nkocode/test-equipment-iphone-duo-foldatron/gallery/assets/rev-c-preview.jpg

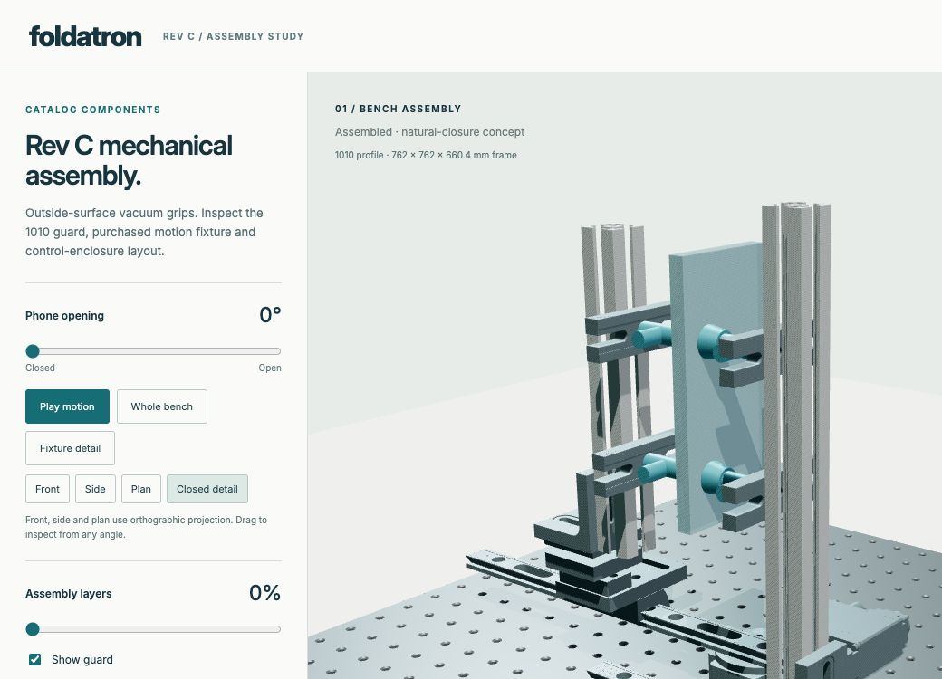
gallery/assets/rev-c-preview.jpg
