nkocode/test-equipment-iphone-duo-foldatron/revisions/rev-b/project/hardware/rev-b/cad/fasteners/README.md

# Standard-derived fastener envelopes

Nominal ISO4762 geometry from Bossard BN612 dimensional tables (S28). These are project-generated STEP files, not original Bossard CAD. Threads, under-head radii and finish are omitted. Use the fastener schedule for length, thread, strength and quantity; do not manufacture screws from these envelopes.
