nkocode/test-equipment-iphone-duo-foldatron/revisions/rev-b/project/hardware/rev-b/THIRD-PARTY-NOTICES.md

# Third-party notices

The E-005 board-placement drawing, `views/controller-board.png`,
and the Adafruit-derived grid in
`controller-board.json` are adaptations of the Perma-Proto Half board,
designed by Limor Fried/Ladyada for Adafruit Industries. They are licensed
under Creative Commons Attribution-ShareAlike 3.0 Unported, not the
repository MIT license. Changes: added foldatron component placement,
wiring assignments, dimensions and circuit connectivity verification.

Original source: https://github.com/adafruit/Adafruit-Perma-Proto-PCB
Product: https://www.adafruit.com/product/1609
License: https://creativecommons.org/licenses/by-sa/3.0/

The complete original attribution/readme and license are retained in
`third-party/adafruit/`. The original EAGLE file is retained unchanged in
the local vendor-reference archive and can be fetched from source S36.
Other sheets in the drawing-book collection retain their own licenses.
The project generation scripts remain under the repository MIT license.

Vendor datasheets and original CAD retain their respective copyrights.
They are not relicensed by the project. The source register distinguishes
original downloads, reconstructed geometry and unavailable source files.
