nkocode/test-equipment-iphone-duo-foldatron/gallery/assets/rev-a-preview.jpg

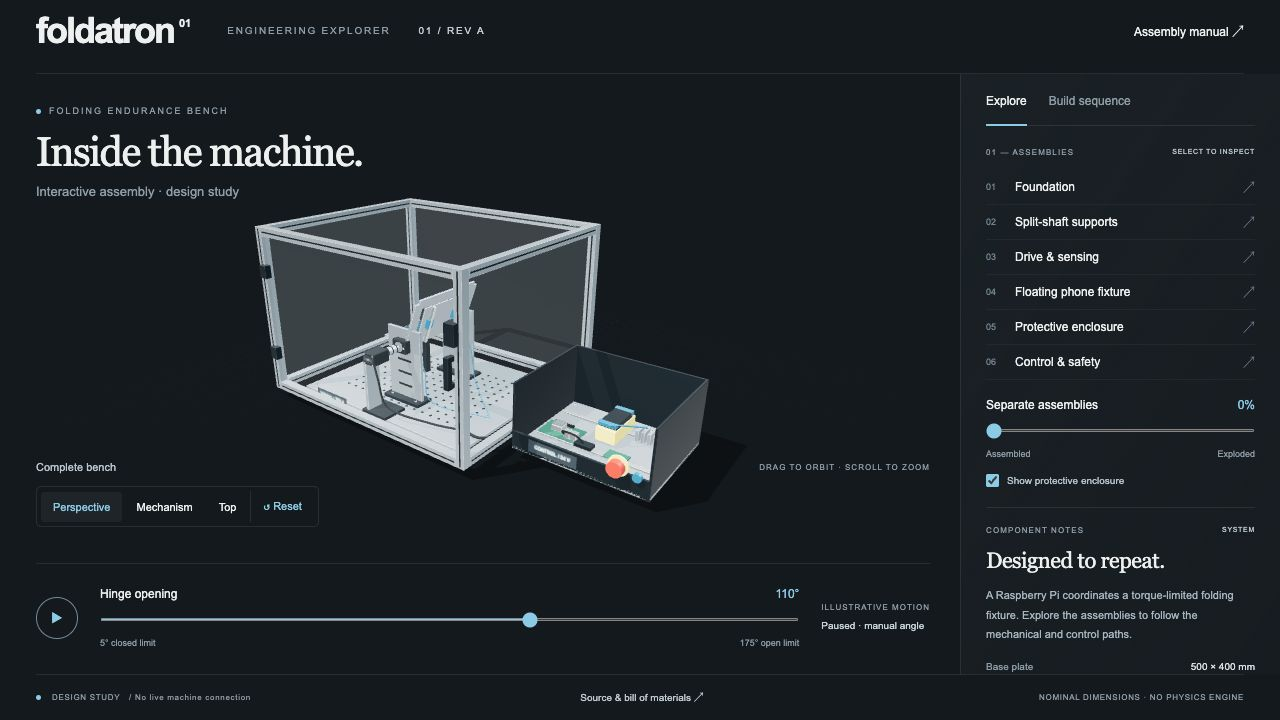
gallery/assets/rev-a-preview.jpg
