nkocode/test-equipment-iphone-duo-foldatron/revisions/rev-c/hardware/cad/top-interface-study.step

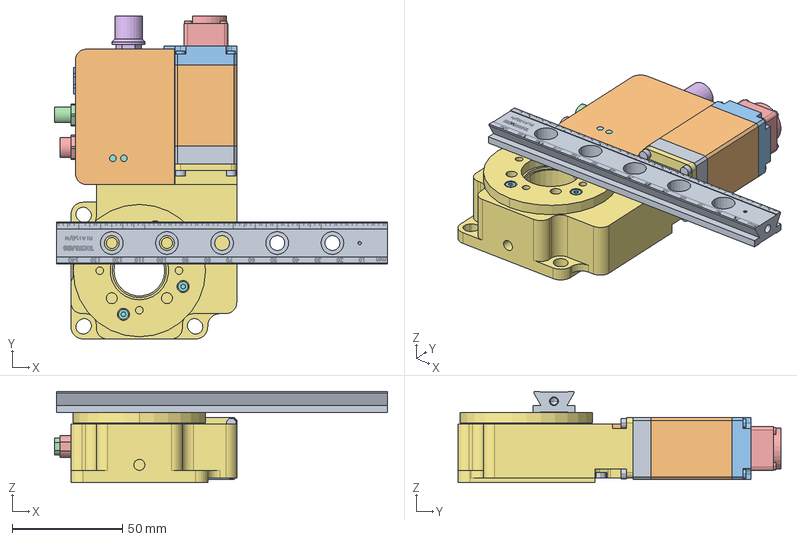
[picture p3: CAD file, 2026-11-13]
revisions/rev-c/hardware/cad/top-interface-study.step
151.0 x 146.4 x 41.3 mm
