nkocode/test-equipment-iphone-duo-foldatron/revisions/rev-c/hardware/cad/structure-study.step

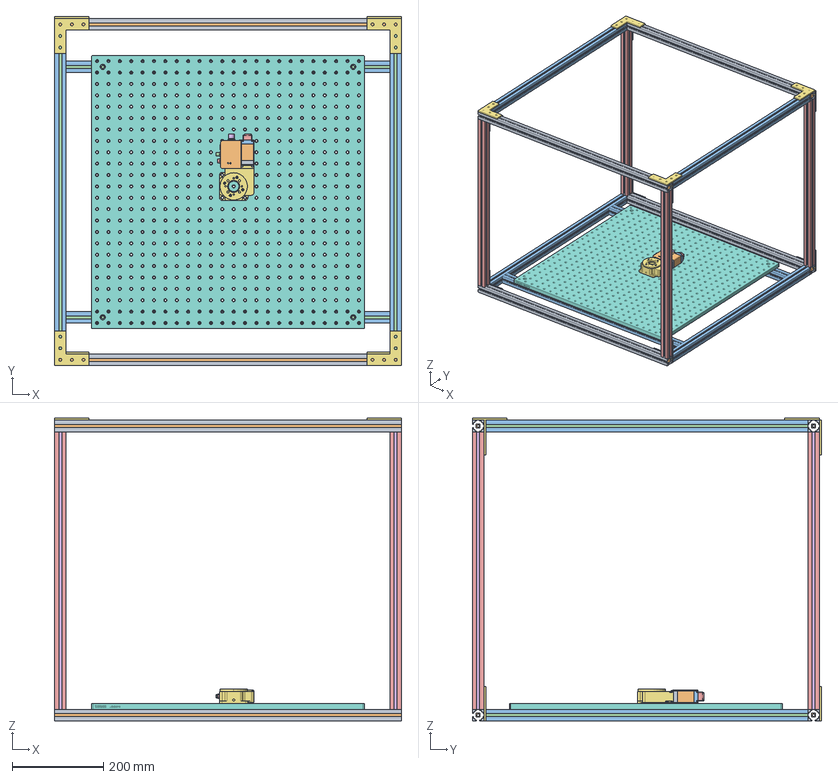
[picture p4: CAD file, 2026-11-13]
revisions/rev-c/hardware/cad/structure-study.step
762.0 x 766.8 x 665.2 mm
