nkocode/test-equipment-iphone-duo-foldatron/revisions/rev-b/project/hardware/rev-b/cad/B105.step

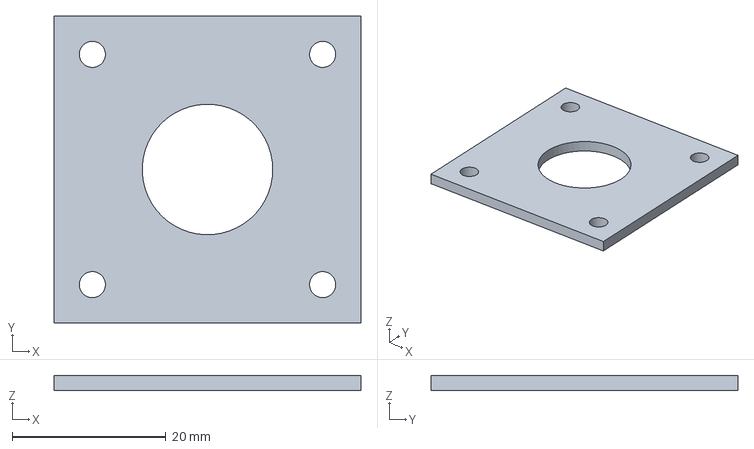
[picture p5: CAD file, 2026-11-06, an earlier design]
revisions/rev-b/project/hardware/rev-b/cad/B105.step
40.0 x 40.0 x 2.00 mm
