nkocode/test-equipment-iphone-duo-foldatron/revisions/rev-b/project/hardware/rev-b/cad/B102.step

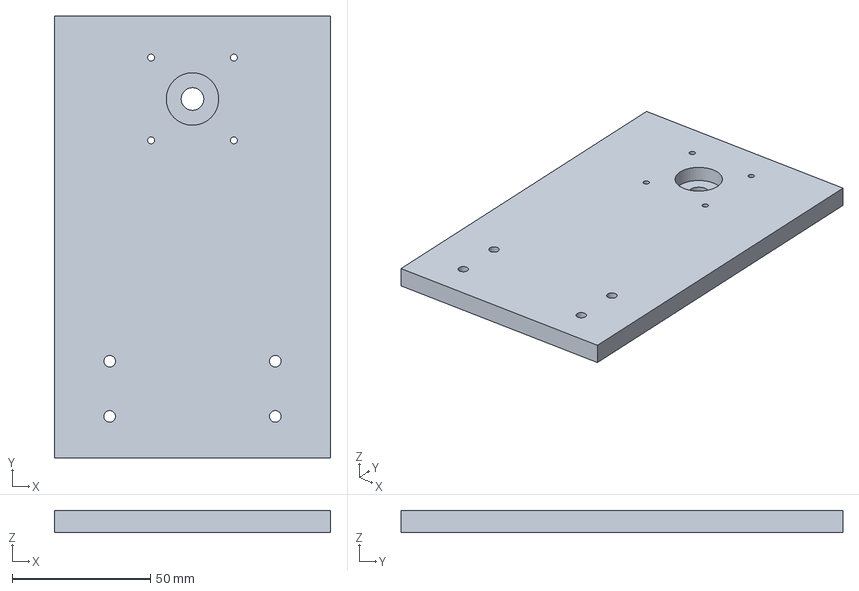
[picture p6: CAD file, 2026-11-06, an earlier design]
revisions/rev-b/project/hardware/rev-b/cad/B102.step
100.0 x 160.0 x 8.00 mm
