nkocode/test-equipment-iphone-duo-foldatron/revisions/rev-b/project/hardware/rev-b/cad/B114.step

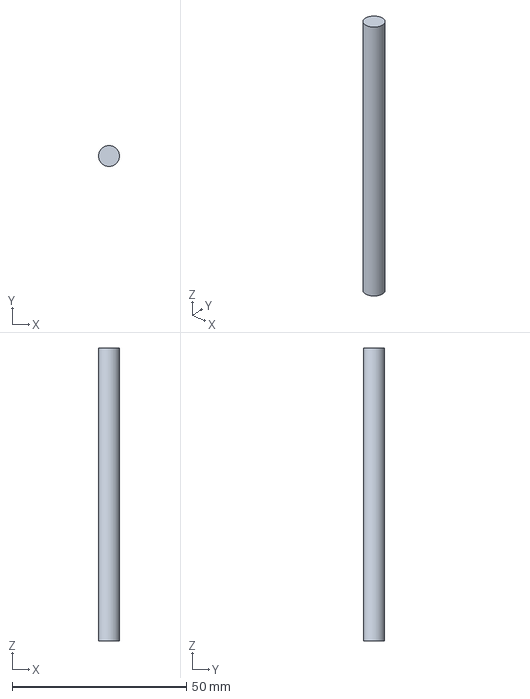
[picture p7: CAD file, 2026-11-06, an earlier design]
revisions/rev-b/project/hardware/rev-b/cad/B114.step
5.99 x 6.00 x 84.0 mm
