nkocode/test-equipment-iphone-duo-foldatron/revisions/rev-b/project/hardware/rev-b/cad/B129.step

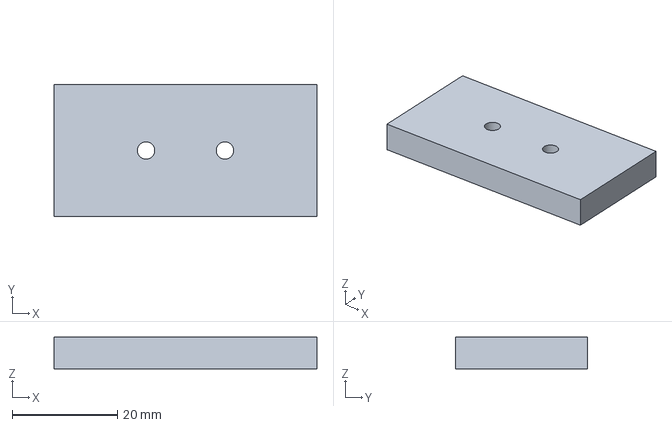
[picture p8: CAD file, 2026-11-06, an earlier design]
revisions/rev-b/project/hardware/rev-b/cad/B129.step
50.0 x 25.0 x 6.00 mm
