nkocode/test-equipment-iphone-duo-foldatron/revisions/rev-b/project/hardware/rev-b/cad/B123.step

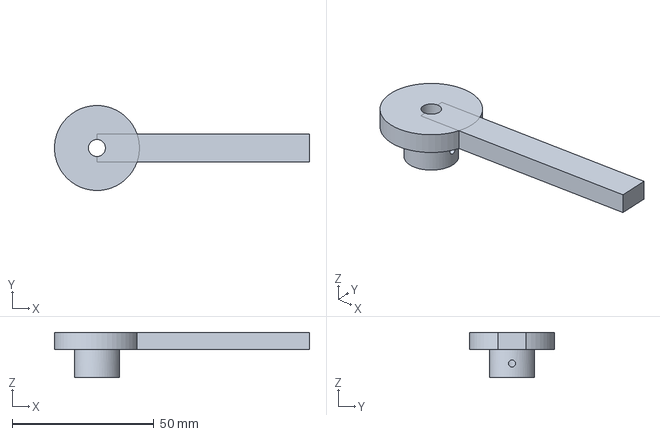
[picture p9: CAD file, 2026-11-06, an earlier design]
revisions/rev-b/project/hardware/rev-b/cad/B123.step
90.0 x 30.0 x 16.0 mm
