nkocode/test-equipment-iphone-duo-foldatron/revisions/rev-b/project/hardware/rev-b/cad/foldatron-rev-b.step

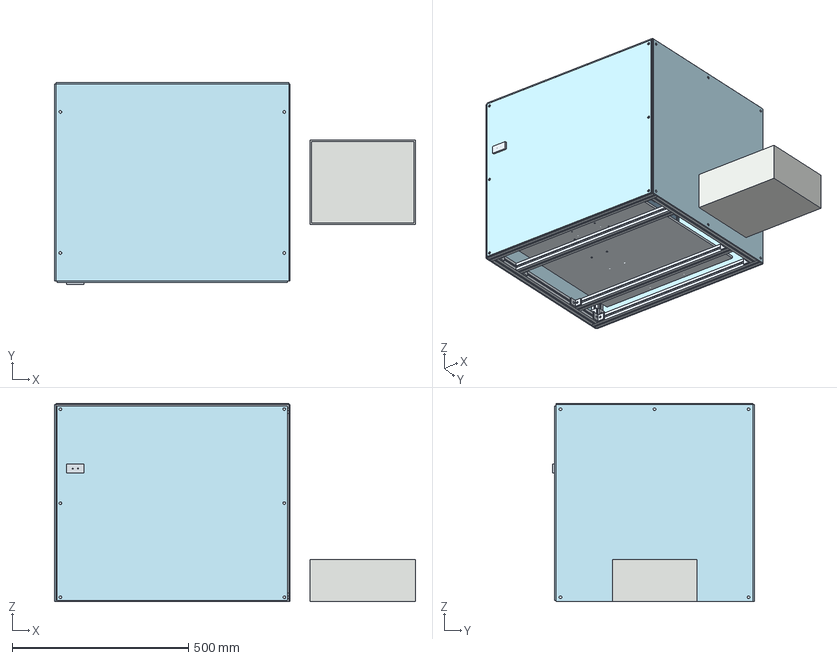
[picture p17: CAD file, 2026-11-06, an earlier design]
revisions/rev-b/project/hardware/rev-b/cad/foldatron-rev-b.step
1023.9 x 572.8 x 562.8 mm
lower_x_-266_7
lower_x_266_7
lower_y_-317_5
lower_y_317_5
upper_x_-266_7
upper_x_266_7
upper_y_-317_5
upper_y_317_5
post_-317_5_-266_7
post_-317_5_266_7
post_317_5_-266_7
post_317_5_266_7
crossmember_-150
crossmember_150
post_joint_x_-1_-1_-8
post_joint_y_-1_-1_-8
post_joint_x_-1_1_-8
post_joint_y_-1_1_-8
post_joint_x_1_-1_-8
post_joint_y_1_-1_-8
post_joint_x_1_1_-8
post_joint_y_1_1_-8
post_joint_x_-1_-1_500
post_joint_y_-1_-1_500
post_joint_x_-1_1_500
post_joint_y_-1_1_500
post_joint_x_1_-1_500
post_joint_y_1_-1_500
post_joint_x_1_1_500
post_joint_y_1_1_500
rail_corner_-1_-1_-20_7
rail_corner_-1_1_-20_7
rail_corner_1_-1_-20_7
rail_corner_1_1_-20_7
rail_corner_-1_-1_512_7
rail_corner_-1_1_512_7
rail_corner_1_-1_512_7
rail_corner_1_1_512_7
cross_joint_-1_-1
cross_joint_-1_1
cross_joint_1_-1
cross_joint_1_1
base
tower_front
sole_front
angle_front
retainer_front
bearing_front
arm_front
hub_front
weight_adjust_front
weight_front
spacer_front_inner
spacer_front_outer
collar_front_105_05
collar_front_126_05
tower_rear
sole_rear
angle_rear
retainer_rear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
