nkocode/test-equipment-iphone-duo-foldatron/(list of files, cad)

Other CAD files:
revisions/rev-c/hardware/cad/bench-development.step
revisions/rev-c/hardware/cad/fixture-development.step
revisions/rev-b/project/hardware/rev-b/cad/B203.step
revisions/rev-a/project/hardware/foldbench.scad
revisions/rev-b/project/hardware/foldbench.scad
revisions/rev-b/project/hardware/rev-b/cad/B101.dxf
revisions/rev-b/project/hardware/rev-b/cad/B101.step
revisions/rev-b/project/hardware/rev-b/cad/B103.dxf
revisions/rev-b/project/hardware/rev-b/cad/B103.step
revisions/rev-b/project/hardware/rev-b/cad/B104.step
revisions/rev-b/project/hardware/rev-b/cad/B105.dxf
revisions/rev-b/project/hardware/rev-b/cad/B106.dxf
revisions/rev-b/project/hardware/rev-b/cad/B106.step
revisions/rev-b/project/hardware/rev-b/cad/B107.step
revisions/rev-b/project/hardware/rev-b/cad/B108.dxf
revisions/rev-b/project/hardware/rev-b/cad/B108.step
revisions/rev-b/project/hardware/rev-b/cad/B109.dxf
revisions/rev-b/project/hardware/rev-b/cad/B109.step
revisions/rev-b/project/hardware/rev-b/cad/B110.step
revisions/rev-b/project/hardware/rev-b/cad/B111.dxf
revisions/rev-b/project/hardware/rev-b/cad/B111.step
revisions/rev-b/project/hardware/rev-b/cad/B112.step
revisions/rev-b/project/hardware/rev-b/cad/B113.step
revisions/rev-b/project/hardware/rev-b/cad/B116.step
revisions/rev-b/project/hardware/rev-b/cad/B117.dxf
revisions/rev-b/project/hardware/rev-b/cad/B118.step
revisions/rev-b/project/hardware/rev-b/cad/B119.dxf
revisions/rev-b/project/hardware/rev-b/cad/B120.dxf
revisions/rev-b/project/hardware/rev-b/cad/B120.step
revisions/rev-b/project/hardware/rev-b/cad/B122.step
revisions/rev-b/project/hardware/rev-b/cad/B125.step
revisions/rev-b/project/hardware/rev-b/cad/B126.dxf
revisions/rev-b/project/hardware/rev-b/cad/B127.step
revisions/rev-b/project/hardware/rev-b/cad/B128.step
revisions/rev-b/project/hardware/rev-b/cad/B130.step
revisions/rev-b/project/hardware/rev-b/cad/B201.dxf
revisions/rev-b/project/hardware/rev-b/cad/B201.step
revisions/rev-b/project/hardware/rev-b/cad/B202.dxf
revisions/rev-b/project/hardware/rev-b/cad/B203.dxf
revisions/rev-b/project/hardware/rev-b/cad/B204.dxf
revisions/rev-b/project/hardware/rev-b/cad/B204.step
revisions/rev-b/project/hardware/rev-b/cad/fasteners/ISO4762-M2.5x8.step
revisions/rev-b/project/hardware/rev-b/cad/fasteners/ISO4762-M2x12.step
revisions/rev-b/project/hardware/rev-b/cad/fasteners/ISO4762-M2x16.step
revisions/rev-b/project/hardware/rev-b/cad/fasteners/ISO4762-M2x6.step
revisions/rev-b/project/hardware/rev-b/cad/fasteners/ISO4762-M2x8.step
revisions/rev-b/project/hardware/rev-b/cad/fasteners/ISO4762-M3x12.step
revisions/rev-b/project/hardware/rev-b/cad/fasteners/ISO4762-M3x8.step
revisions/rev-b/project/hardware/rev-b/cad/fasteners/ISO4762-M4x10.step
revisions/rev-b/project/hardware/rev-b/cad/fasteners/ISO4762-M4x12.step
revisions/rev-b/project/hardware/rev-b/cad/fasteners/ISO4762-M4x16.step
revisions/rev-b/project/hardware/rev-b/cad/fasteners/ISO4762-M4x20.step
revisions/rev-b/project/hardware/rev-b/cad/fasteners/ISO4762-M5x12.step
revisions/rev-b/project/hardware/rev-b/cad/fasteners/ISO4762-M5x14.step
revisions/rev-b/project/hardware/rev-b/cad/fasteners/ISO4762-M5x16.step
revisions/rev-b/project/hardware/rev-b/cad/fasteners/ISO4762-M5x20.step
revisions/rev-b/project/hardware/rev-b/cad/fasteners/ISO4762-M6x16.step
revisions/rev-b/project/hardware/rev-b/cad/fasteners/ISO4762-M6x25.step
