nkocode/test-equipment-iphone-duo-foldatron/revisions/rev-b/project/docs/rev-b/Foldatron-Rev-B-assembly-traveler.pdf

# Assembly traveler

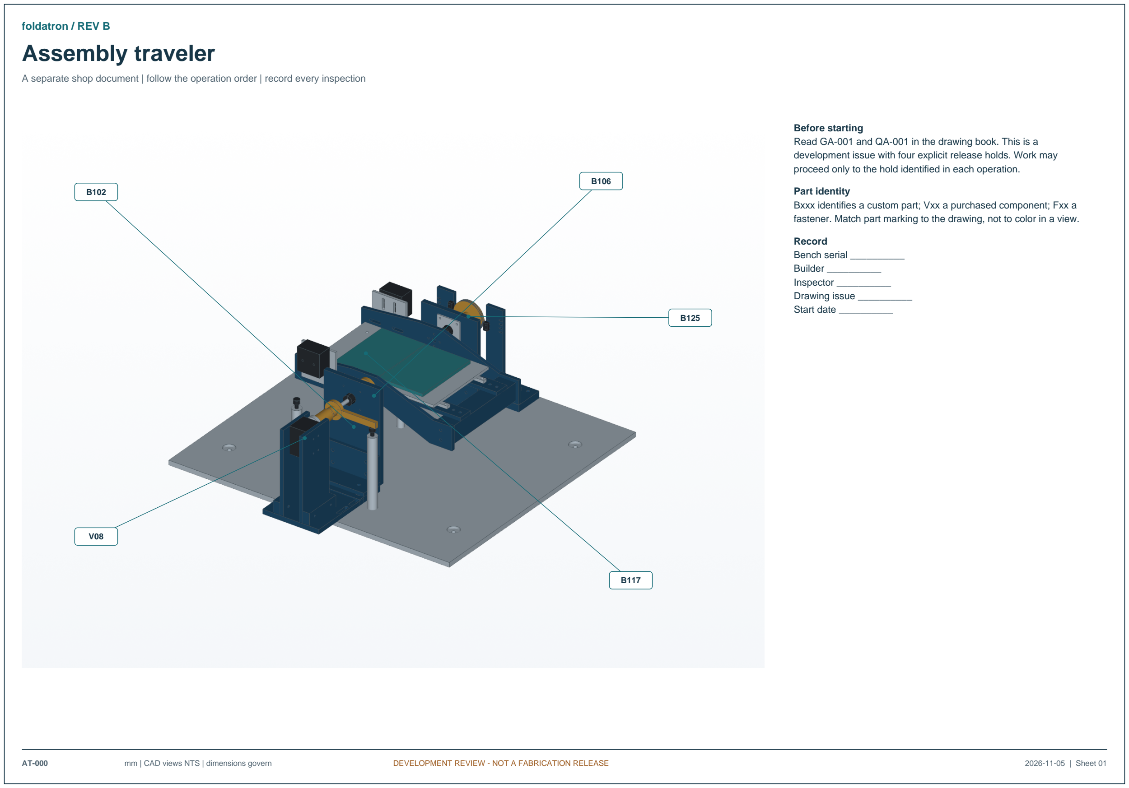
[picture p52: page 1]

foldatron / REV B

A separate shop document | follow the operation order | record every inspection
AT-000 | mm | CAD views NTS | dimensions govern | DEVELOPMENT REVIEW - NOT A FABRICATION RELEASE | 2026-11-05 | Sheet 01

B102

B106

V08

B117

B125

Before starting
Read GA-001 and QA-001 in the drawing book. This is a development issue with four explicit release holds. Work may proceed only to the hold identified in each operation.

Part identity
Bxxx identifies a custom part; Vxx a purchased component; Fxx a fastener. Match part marking to the drawing, not to color in a view.

Record
Bench serial __________
Builder __________
Inspector __________
Drawing issue __________
Start date __________

# 01 / Receive, identify and measure

All purchased parts | source register | caliper, micrometer, thread gauges
AT-001 | mm | CAD views NTS | dimensions govern | DEVELOPMENT REVIEW - NOT A FABRICATION RELEASE | 2026-11-05 | Sheet 02

### 1. Record manufacturer, exact part number, lot and quantity. Keep certificates

and vendor drawings with the bench serial record.

### 2. Check 1010 is 25.4 mm square. Do not mix 2020 extrusion, metric T-nuts or

another vendor's visually similar profile.

### 3. Measure bearing 6 x 19 x 6, collar bore 6, guide height 8 and guide-block

pattern 12 x 8. Check purchased block thread pitch before trying a screw.

### 4. For the configured clutch, compare its signed dimensional drawing with

ME-002 and the motor adapter. Verify exact 6 mm bores, not nominal quarter-inch bores.

Inspection / stop point
No substituted part proceeds solely because its envelope looks similar. Hold P2 if clutch insertion, low-torque setting or guide thread pitch is unconfirmed.

SHOP RECORD
Actual measurement / observation: ______________________________________ _________________________________________________________________ Assembler __________ Inspector __________ Date __________ Pass / Hold

# 02 / Machine and inspect the custom parts

B101-B130 and B201-B204 | individual STEP / DXF | drawing-book hole charts
AT-002 | mm | CAD views NTS | dimensions govern | DEVELOPMENT REVIEW - NOT A FABRICATION RELEASE | 2026-11-05 | Sheet 03

### 1. Use the drawing callouts for threads and counterbores. STEP holes are

modeled at tap-drill size; a cylindrical hole in STEP is not a finished thread specification.

### 2. Machine B101 and B102 datum faces before locating their features. Inspect

B102 19 H7 pockets, depth 6.05 to 6.10, and axis position before fitting bearings.

### 3. Deburr all edges and wash away chips. Keep abrasives out of bearings and

guide carriages. Break phone-adjacent edges and remove sharp pad seams.

### 4. Label each part on a non-contact face with drawing ID and revision. Do not

machine phone contours from the rectangular CAD phone envelope.

Inspection / stop point
Record hole coordinates, bearing-seat diameter and surface flatness. P1 blocks final contact inserts; P2 blocks final clutch-related shaft flats and fit.

SHOP RECORD
Actual measurement / observation: ______________________________________ _________________________________________________________________ Assembler __________ Inspector __________ Date __________ Pass / Hold

# 03 / Build the lower rectangle

2 x V01 at 660.4 | 2 x V02 at 508 | 4 x 4119 | 8 x 3393
AT-003 | mm | CAD views NTS | dimensions govern | DEVELOPMENT REVIEW - NOT A FABRICATION RELEASE | 2026-11-05 | Sheet 04
1. Lay the two long rails front/rear, with the 508 mm side rails between them. Outside size is 660.4 x 558.8.

### 2. Load the required slide-in T-nuts before closing joints. Fit one horizontal

inside-corner bracket at each corner, as modeled.

### 3. Tighten only enough to hold the rectangle. Measure both diagonals on the

same datum corners and adjust until their difference is 0.5 mm or less.

### 4. Record the bracket screw torque selected from current 80/20 assembly

guidance. Verify screw engagement and that no screw bottoms before clamping.

Inspection / stop point
Rectangle lies flat and diagonals agree. Do not use a guessed metric-frame torque for the 1/4-20 hardware.

SHOP RECORD
Actual measurement / observation: ______________________________________ _________________________________________________________________ Assembler __________ Inspector __________ Date __________ Pass / Hold

# 04 / Install the fixture support crossmembers

2 x V03 at 609.6 | 4 x 4119 | 8 x 3393
AT-004 | mm | CAD views NTS | dimensions govern | DEVELOPMENT REVIEW - NOT A FABRICATION RELEASE | 2026-11-05 | Sheet 05

### 1. Place the two 609.6 mm members between the side rails. Their centerlines

are Y=-150 and +150 from frame center.

### 2. Orient the corner brackets toward frame center so they stay clear of the

vertical-post brackets and base-mount bolt positions.

3. Set crossmember top faces coplanar with the bottom rectangle rail tops. These faces sit 8 mm below the fixture-base top datum.

### 4. Slide two T-nuts into each crossmember's upper slot for B101, at X=-200

and +200.

Inspection / stop point
Crossmember spacing is 300.0 +/-0.2; top-face mismatch <=0.10. Check plate support with a straightedge.

SHOP RECORD
Actual measurement / observation: ______________________________________ _________________________________________________________________ Assembler __________ Inspector __________ Date __________ Pass / Hold

# 05 / Complete the cage and square it

4 posts at 508 | upper rectangle | 20 additional 4119 brackets
AT-005 | mm | CAD views NTS | dimensions govern | DEVELOPMENT REVIEW - NOT A FABRICATION RELEASE | 2026-11-05 | Sheet 06
1. Fit the four 508 mm posts on the long lower rails at X=+/-317.5, Y=+/-266.7. Use two orthogonal brackets at each post end. Before closing the left-front post, load two additional3393 T-nuts in its inward X-face slot for the interlock mount.

### 2. Build the upper rectangle with the same rail arrangement as the lower

rectangle, then attach it to the posts.

3. Confirm all 28 structural brackets are present. Work around the frame, squaring each face before final tightening and witness marking.
4. Fit four neoprene support pads under the lower rails near the corners. Place the frame on a rigid level bench and remove rocking.

Inspection / stop point
Outside frame height 558.8 +/-0.5; each face diagonal mismatch <=0.5. Check driver access to every bracket.

SHOP RECORD
Actual measurement / observation: ______________________________________ _________________________________________________________________ Assembler __________ Inspector __________ Date __________ Pass / Hold

# 06 / Mount the base and bearing supports

B101 | 2 each B102/B103/B104 | F11/F12/F14 | 4 recessed 3393 sets

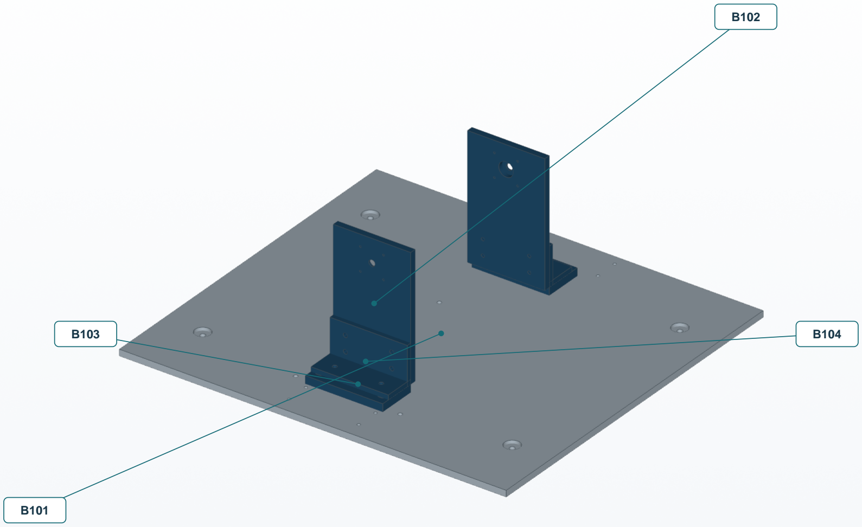
[picture p53: figure]

AT-006 | mm | CAD views NTS | dimensions govern | DEVELOPMENT REVIEW - NOT A FABRICATION RELEASE | 2026-11-05 | Sheet 07

### 1. Install B101 on the crossmembers with its counterbored frame holes at

X=+/-200, Y=+/-150. Fit the 1 mm washers in the recesses.

2. Install each tower sole B103 at center Y=+/-149; the M6 recesses face up. Mirror the front sole so the frame-to-base holes are at Y=-159.

### 3. Bolt B104 angles to B103 using M5 x 14. Fit B102 towers with four M5 x 12

per tower. Leave tower alignment fasteners slightly loose.

### 4. Bearing tower outside faces must finish at Y=+/-124, with the counterbored

bearing pockets facing inward. The shaft axis is X=0, Z=140.

Inspection / stop point
Tower bottoms sit at Z10 and remain perpendicular to the base. Inspect the hole-stack orientation before applying torque.

SHOP RECORD
Actual measurement / observation: ______________________________________ _________________________________________________________________ Assembler __________ Inspector __________ Date __________ Pass / Hold

# 07 / Install bearings, spacers and shafts

2 NSK 626 | B105 retainers | B113/B114 | B115/B116 | 4 Ruland collars

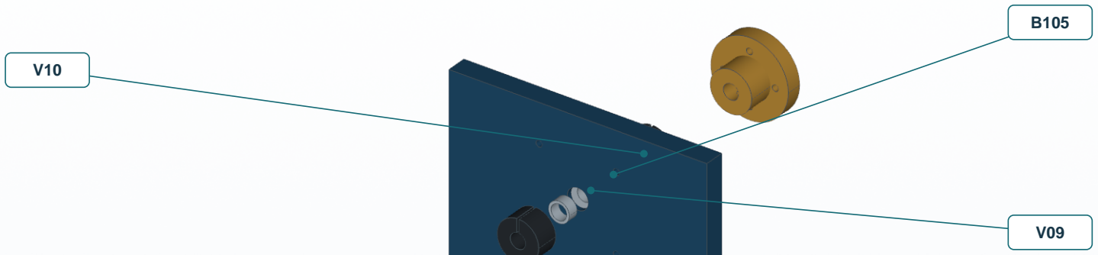
[picture p54: figure]

AT-007 | mm | CAD views NTS | dimensions govern | DEVELOPMENT REVIEW - NOT A FABRICATION RELEASE | 2026-11-05 | Sheet 08

B102

### 1. Support each tower and install the bearing by pressing only on its outer

race. Do not hammer the shaft through the inner ring.

### 2. Install the B105 retaining plate using four M3 x 8 screws. Confirm the plate

retains the outer ring without touching the inner ring.

3. Follow the ME-002 axial stack. Inner spacer is 2 mm; outer spacer is 4 mm. Their 8 mm outer diameters must clear the tower's 8.2 mm passage.

### 4. Use a straight alignment mandrel during tower adjustment, then replace it

with the two separate shafts. No shaft is allowed through the phone.

### 5. Set collars for 0.05-0.10 mm total axial freedom and tighten their supplied

screws to Ruland's 2.1 N m. Recheck free rotation.

Inspection / stop point
A shaft turns freely without cyclic tight spots or perceptible housing rub. Record axis alignment and axial freedom; do not use collar force to correct a misaligned tower.

SHOP RECORD
Actual measurement / observation: ______________________________________ _________________________________________________________________ Assembler __________ Inspector __________ Date __________ Pass / Hold

# 08 / Assemble the yoke and counterweights

2 B106 | B107 | 2 B112 | 2 B111/B120 | F06/F07/F08/F09/F16/F17

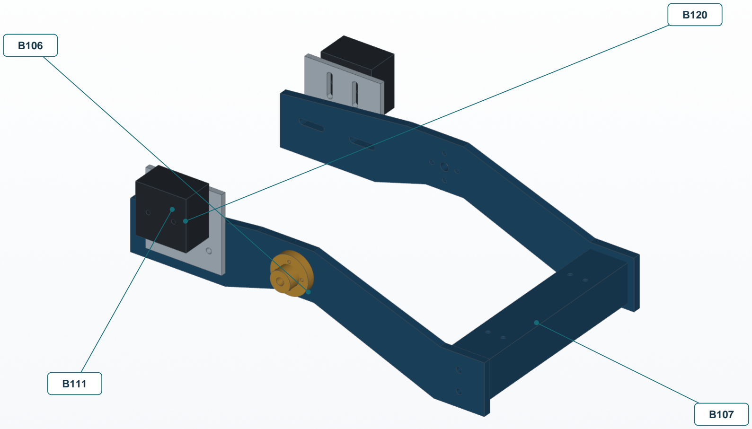
[picture p55: figure]

AT-008 | mm | CAD views NTS | dimensions govern | DEVELOPMENT REVIEW - NOT A FABRICATION RELEASE | 2026-11-05 | Sheet 09

### 1. Bolt each arm to its B112 hub with four M3 x 12 screws on the 20 mm bolt

circle. Orient the front/rear arms as mirrored copies.

### 2. Fit B107 between the arm inner faces, using two M4 x 10 screws at each

end. Its pocket opens downward in the open fixture position.

### 3. Fit each B120 adjustment plate to its arm with two M4 x 20 screws, washers

and locknuts. Fit the steel weight using two M4 x 16 screws through the vertical slots.

### 4. Start both weight centers at X=-85, Z=165. Keep the front and rear weights

at matching settings. Install shaft set screws onto the specified flats.

### 5. Before fitting the phone, proof the hub/cam retention at 0.75 N m using a

calibrated torque method. Inspect witness marks after unloading.

Inspection / stop point
The yoke is square and both arms rotate together without relative hub movement. Slotted joints are clamped, not left loose to provide compliance.

SHOP RECORD
Actual measurement / observation: ______________________________________ _________________________________________________________________ Assembler __________ Inspector __________ Date __________ Pass / Hold

# 09 / Install the linear float

2 B108 | 2 HIWIN MGN7C/100 | B109 | 4 B110 | F01/F02

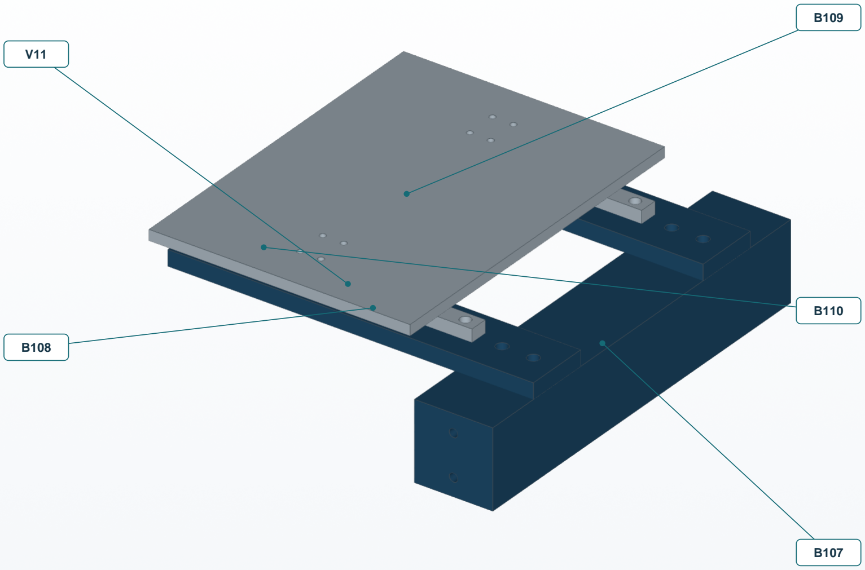
[picture p56: figure]

AT-009 | mm | CAD views NTS | dimensions govern | DEVELOPMENT REVIEW - NOT A FABRICATION RELEASE | 2026-11-05 | Sheet 10

### 1. Bolt B108 carriers to the crossbar at Y=+/-45. Their top mounting faces are

Z124.4 and their center X=75.

### 2. Install rails from X15 to X115 with seven M2 x 6 screws per rail at

X20,35,50,65,80,95,110. Do not remove guide blocks from their rails without a transfer rail.

### 3. Fit B109 using eight M2 x 6 screws: 4 mm plate leaves 2 mm engagement

in each block. Confirm the actual block thread pitch before assembly.

### 4. Align the rails for free travel over the full stroke before tightening. Mount

one rail first, then use the moving plate to align the second without forcing the blocks.

5. Fit four B110 stops, their rail reliefs down. Bond 2 mm pads to inward faces. Measure the travel: block end-seal variants give about 5.7-6.0 mm each way.

Inspection / stop point
Measure peak breakaway force with a force gauge and record it; target <=1 N. No carriage, cap screw or stop may rub another fastener. A binding rail assembly must be realigned.

SHOP RECORD
Actual measurement / observation: ______________________________________ _________________________________________________________________ Assembler __________ Inspector __________ Date __________ Pass / Hold

# 10 / Install the fixed tray and angular stops

B117 | 4 B118 | B123 | 2 B124 | M6 stop screws, nuts and pads
AT-010 | mm | CAD views NTS | dimensions govern | DEVELOPMENT REVIEW - NOT A FABRICATION RELEASE | 2026-11-05 | Sheet 11

B123

B124

### 1. Bolt the four B118 posts to B101 from below using M5 x 16. Fit B117 on top

with four M4 x 12. The bare tray top is Z136.4.

### 2. Install the output stop cam at Y=-180, with its tab pointing +X in the open

fixture datum. Its tab spans Y=-170 to -164.

### 3. Fit the stop posts at X=+/-67.5, Y=-167. Fit M6 x 25 screws, jam nuts and 1

mm soft pads. The CAD backup-stop contact height is Z135 for 0/180 degrees.

### 4. Use an angle gauge to set the real backup stops beyond the intended

5..175 degree working range, while remaining within the measured phone limits. Normal cycling must not hit the stops.

### 5. Turn the complete assembly by hand through the permitted travel. Repeat

after changing any counterweight setting or adding wires.

Inspection / stop point
Record both physical stop angles and minimum clearances. The nominal CAD sweep found 6.67 mm minimum base clearance, but it excludes wires and screw heads and is not a physical acceptance result.

SHOP RECORD
Actual measurement / observation: ______________________________________ _________________________________________________________________ Assembler __________ Inspector __________ Date __________ Pass / Hold

# 11 / Fit the actuator and configured clutch

B119 cheeks | B121 pedestal | B122 adapter | XM430 | EAS12 clutch

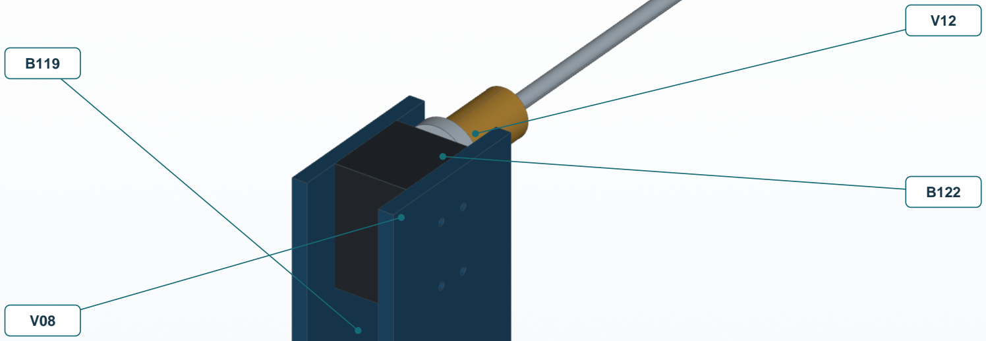
[picture p57: figure]

AT-011 | mm | CAD views NTS | dimensions govern | DEVELOPMENT REVIEW - NOT A FABRICATION RELEASE | 2026-11-05 | Sheet 12

B121

### 1. Complete P2 before this operation: approved clutch drawing, two 6 mm

bores, insertion depths, set-screw positions, and validated low-torque setting.

### 2. Bolt the motor cheeks to the pedestal and install the actuator. M2.5 x 8

through the 6 mm cheek gives 2 mm engagement; the case permits no more than 3 mm.

### 3. Check B122's center relief clears the horn retaining screw by at least 0.5

mm. Attach with four M2 x 8 screws and 0.2 mm shim washers, giving 1.8 mm horn engagement.

### 4. Align the actuator, clutch and supported output shaft without pulling them

together with screws. Use the pedestal slots; usable shift is -3 to +9.75 mm because the guard limits forward motion.

### 5. Set the clutch with the phone absent. At a 100 mm lever radius, 2.0 N

corresponds to 0.20 N m. Verify clockwise and counterclockwise breakaway and running slip, cold and warm.

Inspection / stop point
No axial preload or forced shaft misalignment. Record actual insertion lengths, bore fits and clutch measurements. Do not replace a slip-clutch test with a servo-current limit setting.

SHOP RECORD
Actual measurement / observation: ______________________________________ _________________________________________________________________ Assembler __________ Inspector __________ Date __________ Pass / Hold

# 12 / Measure the actual phone and release inserts

Actual iPhone Duo | B109/B117 | soft-contact insert stock | dummy specimen
AT-012 | mm | CAD views NTS | dimensions govern | DEVELOPMENT REVIEW - NOT A FABRICATION RELEASE | 2026-11-05 | Sheet 13

### 1. The owner has directed the shop to measure the phone before machining

contact inserts. Record model/serial, case fitted or bare, overall length, both half widths and thickness at every intended contact.

### 2. Record camera protrusion, buttons, connectors, seam and display keep-out

zones. Measure hinge translation relative to the back surfaces at several angles; do not assume a fixed pin axis.

### 3. Design and release replaceable contact inserts and retainers from those

measurements. Support the case/frame only. Provide compliance for measured hinge motion without loading the display or hinge gap.

### 4. Build a two-leaf dummy with the measured contact envelope. Fit 1 mm

pads, inspect retention under slow manual folding, and document the remaining free float.

### 5. Photograph and dimension the approved contacts. Add the final insert

drawings, material and fasteners to the controlled BOM before machining production copies.

Inspection / stop point
P1 closes only after the measured insert design and dummy fit are signed. The CAD envelope is not an iPhone Duo dimensional specification.

SHOP RECORD
Actual measurement / observation: ______________________________________ _________________________________________________________________ Assembler __________ Inspector __________ Date __________ Pass / Hold

# 13 / Balance the complete moving assembly

Complete yoke, dummy and all moving cables | force gauge and 100 mm lever
AT-013 | mm | CAD views NTS | dimensions govern | DEVELOPMENT REVIEW - NOT A FABRICATION RELEASE | 2026-11-05 | Sheet 14

### 1. Disconnect the motor/clutch drive from the output so servo holding torque

cannot hide imbalance. Keep the yoke supported while adjusting weights.

### 2. Measure the force needed to hold the yoke at 0,30,60,90,120,150 and180

degrees, or the actual permitted subset. Convert force at a 100 mm radius to torque by multiplying by 0.1.

3. Adjust both B120 plates equally in X to reduce the open-position moment; adjust the weight positions in Z to reduce the quarter-turn moment. Repeat until the whole sweep meets the residual target.

### 4. Target residual gravity torque <=0.02 N m; equivalent tangential force

<=0.20 N at 100 mm. Use an instrument with suitable resolution and uncertainty.

### 5. If the adjustment range cannot balance the measured phone/dummy, revise

the weight mass and recheck the whole swept envelope. Do not enlarge slots casually.

Inspection / stop point
Record seven signed torque values, gauge calibration and final weight coordinates. Reconnect drive only after the locknuts and witness marks have been checked.

SHOP RECORD
Actual measurement / observation: ______________________________________ _________________________________________________________________ Assembler __________ Inspector __________ Date __________ Pass / Hold

# 14 / Install and set output-side endpoint sensors

B125-B127 | 2 D2F-01L-D3 | F10/F19/F20/F23-F28 | continuity meter

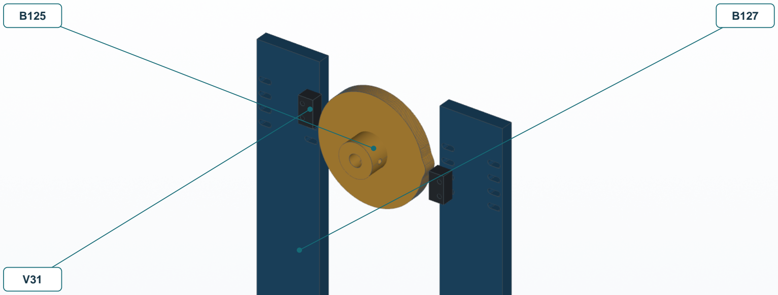
[picture p58: figure]

AT-014 | mm | CAD views NTS | dimensions govern | DEVELOPMENT REVIEW - NOT A FABRICATION RELEASE | 2026-11-05 | Sheet 15

B126

1. Bolt B126 to B101 at X=+/-67.5,Y187/217 with M5 x20 and1mm washers. Install B127 uprights at X=+/-43.8,Y167,Z12 using M4 x12 and1mm washers. Confirm3mm sole-to-sole gap and2mm clearance under each overhanging foot.
2. Fit B125 on the rear output shaft, barrel Y151..161 and disc Y161..167. Index its raised lobe toward+X at the open datum. Lightly secure the acetal hub with two M3 x4 flat-point screws; this cam carries no drive torque.

### 3. Install the right switch on the inward lower slot pair and the left switch on

the inward upper pair, rotated180deg about Y. Use M2 x16, a plain washer at each head, a spring washer and hex nut behind the upright. Tighten0.08..0.10Nm.

### 4. With motor power isolated, adjust each radial position while measuring

electrical make/release and actual lever motion. At peak lift, set0.35..0.45mm travel beyond make; confirm no body contact and full release at mid-travel.

5. Wire switch COM to Pi5V(pin2), NO through1.8kohm/1% to GPIO, and2.7kohm/1% from GPIO to GND. Measure the divider output with Pi disconnected. Record make/release near5/175deg and peak overtravel. Solder at300C maximum for3seconds; leave undisturbed1minute.

Inspection / stop point
Record both make/release angles, peak overtravel and mid-travel states. Reject if either lever is overstroked, a switch does not release, the cam slips or a cable touches the moving assembly. Guard hold P3 remains separate.

SHOP RECORD
Actual measurement / observation: ______________________________________ _________________________________________________________________ Assembler __________ Inspector __________ Date __________ Pass / Hold

# 15 / Install the guard and reinforced interlock mount

B201-B204 | B128-B130 | D4NS-1BF/D4DS-K2 | 2 additional3393 sets | F29-F33

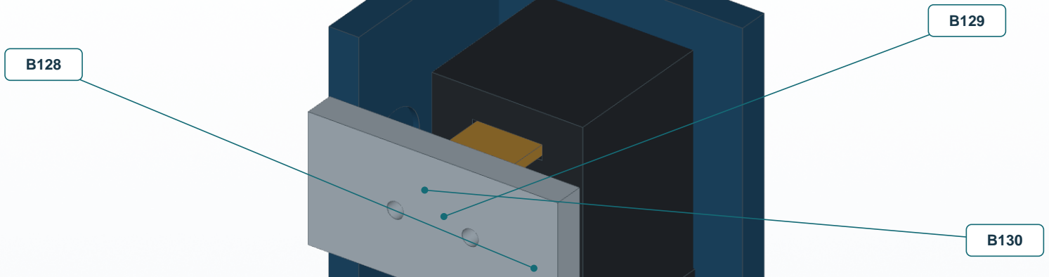
[picture p59: figure]

AT-015 | mm | CAD views NTS | dimensions govern | DEVELOPMENT REVIEW - NOT A FABRICATION RELEASE | 2026-11-05 | Sheet 16

V29

### 1. Fit fixed panels using28 panel fasteners and18mm washers. The six-screw

front panel has3mm edge gaps and no hinges. Keep motor power isolated while fitting the interlock.

### 2. Fit B128 to the inward face of the left-front post, origin

X=-275,Y=-238.15,Z255. Use two3393 sets at global Z290/340 in the counterbored side holes. Fit the D4NS using the diagonal22x47mm pattern and trimmed M4x50 screw blanks; record the finished lengths.

### 3. Measure front-panel thickness and finish the two B130 sleeves

to0.10..0.15mm longer. Put them through the D7 holes. Fit B129 outside and the D4DS-K2 inside, using M4x12 screws and washers. Body torque0.5..0.7Nm; key torque2.4..2.8Nm. Check the sleeves carry the clamp load.

### 4. Measure from the switch rear seating face to the key seating

face:40..42.5mm, nominal41.15. Align the tip within+/-1mm of the key opening in both axes. The panel must stop against the frame, not against the switch.

5. Test square withdrawal of the panel and both independent NC channels. Record the first opening gap at which either channel changes and ensure permit is lost before motion is reachable. Recheck endpoint make/release angles, clearance and cable strain after all panels are fitted.

Inspection / stop point
P3 requires actual insertion/actuation, anti-tamper and access/stopping tests. Geometry is supplied in ME-003/004 and B125-B130; no physical acceptance is claimed by the CAD.

SHOP RECORD
Actual measurement / observation: ______________________________________ _________________________________________________________________ Assembler __________ Inspector __________ Date __________ Pass / Hold

# 16 / Lay out the electrical cabinet

Hammond1554YA2GY/1554YPL | 2 PNOZ X3 | terminals | NC3FD-LX/NC4FD-LX

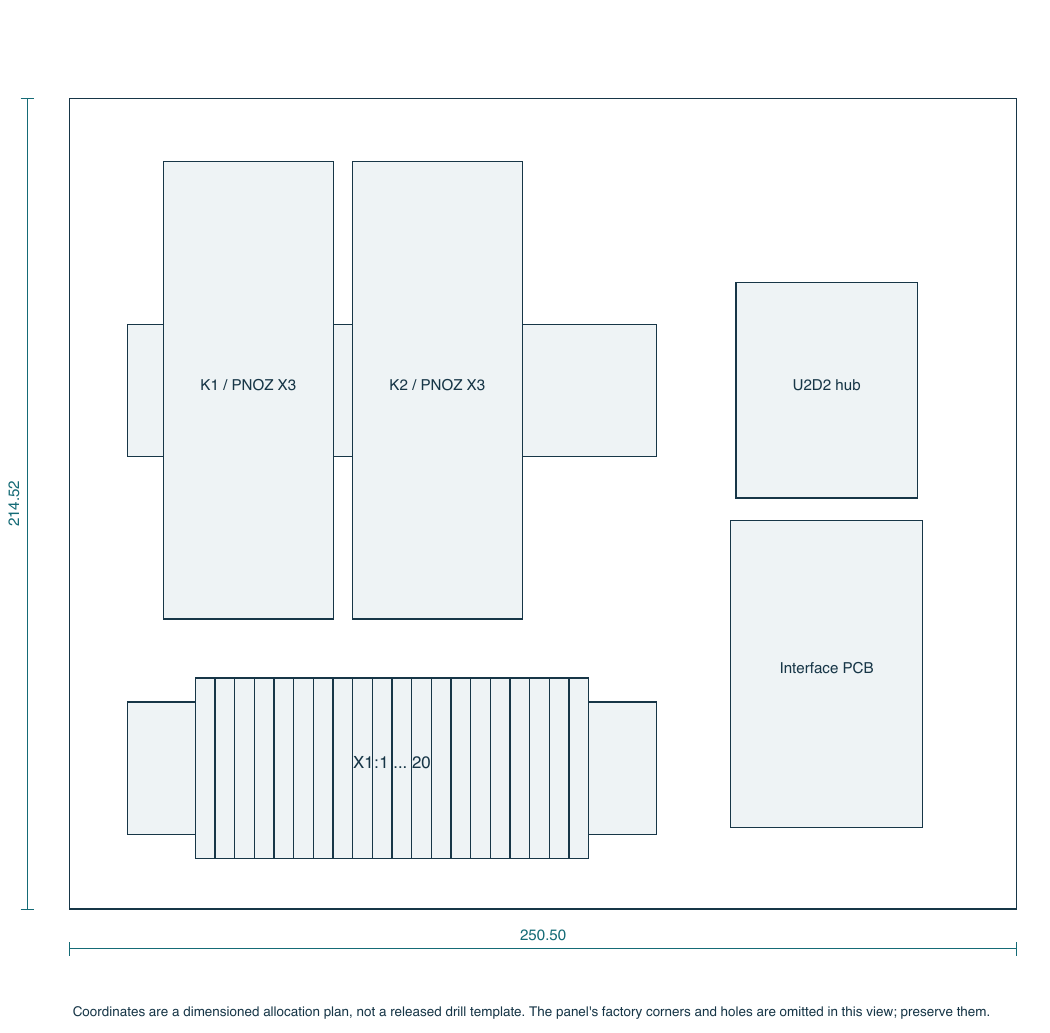
[picture p60: figure]

AT-016 | mm | CAD views NTS | dimensions govern | DEVELOPMENT REVIEW - NOT A FABRICATION RELEASE | 2026-11-05 | Sheet 17
1. Use E-003 and E-009 for the backplate allocation and proposed cutouts. Trial-fit the purchased enclosure, relays, hub, interface board, inlet bodies and lid operators before drilling. Record minimum lid and wiring clearance.

### 2. Lay out both safety relays, terminal strips, power hub and wire ducts with

service clearance. Keep the Raspberry Pi and active cooler outside the sealed cabinet.

### 3. Use the Neutrik drawing: D24.0 +0.1/0 opening and two diagonal M3 mount

centers on a 19 x 24 rectangle. Do not infer the pattern from the connector's circular body.

### 4. Label the three-pin inlet 12V DC and the four-pin inlet 24V DC. Use

different mating connectors and project pin assignments; these are not audio ports.

### 5. Complete P4: approve the dry-fit layout, selected fuse coordination, board

supports/cover, connector harness and probe housings. Use E-010 for isolation of all three external supplies; no unqualified DC disconnect is assumed.

Inspection / stop point
No exposed mains is wired inside this cabinet. Factory external bricks and the Pi supply remain outside. The enclosure's original IP rating is not claimed after these modifications.

SHOP RECORD
Actual measurement / observation: ______________________________________ _________________________________________________________________ Assembler __________ Inspector __________ Date __________ Pass / Hold

# 17 / Build and bench-test the controller interface board

V43-V51 | E-005 through E-008 | original Adafruit1609 PCB

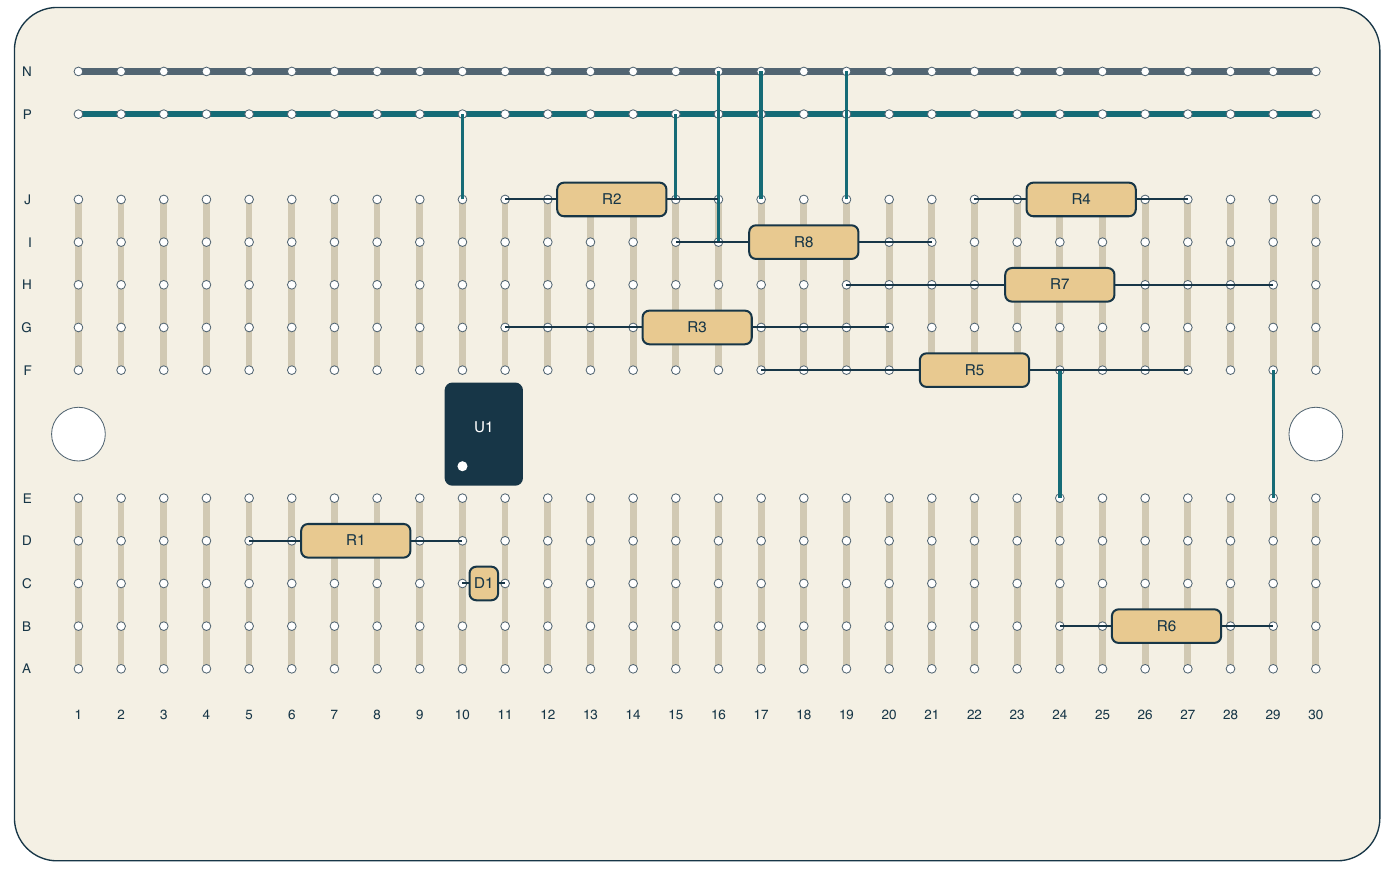
[picture p61: figure]

AT-017 | mm | CAD views NTS | dimensions govern | DEVELOPMENT REVIEW - NOT A FABRICATION RELEASE | 2026-11-05 | Sheet 18

### 1. Inspect the purchased PCB against E-005. Confirm column strips and

separate power rails before fitting components; identify column1 and rowA on the component side.

### 2. Fit the seven insulated jumpers and eight resistors from E-006. Sleeve all

crossovers. Fit D1 cathode atC10 and U1 pin1 atE10. Do not mirror the top-side hole schedule.

3. Solder and inspect every joint under magnification. Keep one lead per hole, trim tails, clean flux and inspect for bridges. The software copper check does not inspect your soldering.
4. Perform E-008 isolated bench tests with Pi and motor disconnected. Record both endpoint voltages, permit high/low and the actual 5V supply under load.

### 5. Tag external leads using E-007. Fit insulating supports, cover and cable

strain relief only after the cabinet dry fit; preserve access for inspection.

Inspection / stop point
Record measured results. Do not attach GPIO until every high is below3.3V, endpoint COM remains5.00..5.25V under load, and return wiring matches E-007.

SHOP RECORD
Actual measurement / observation: ______________________________________ _________________________________________________________________ Assembler __________ Inspector __________ Date __________ Pass / Hold

# 18 / Wire and inspect the independent stop circuit

K1 E-stop relay | K2 guard relay | separate reset buttons | approved E-001 wire schedule

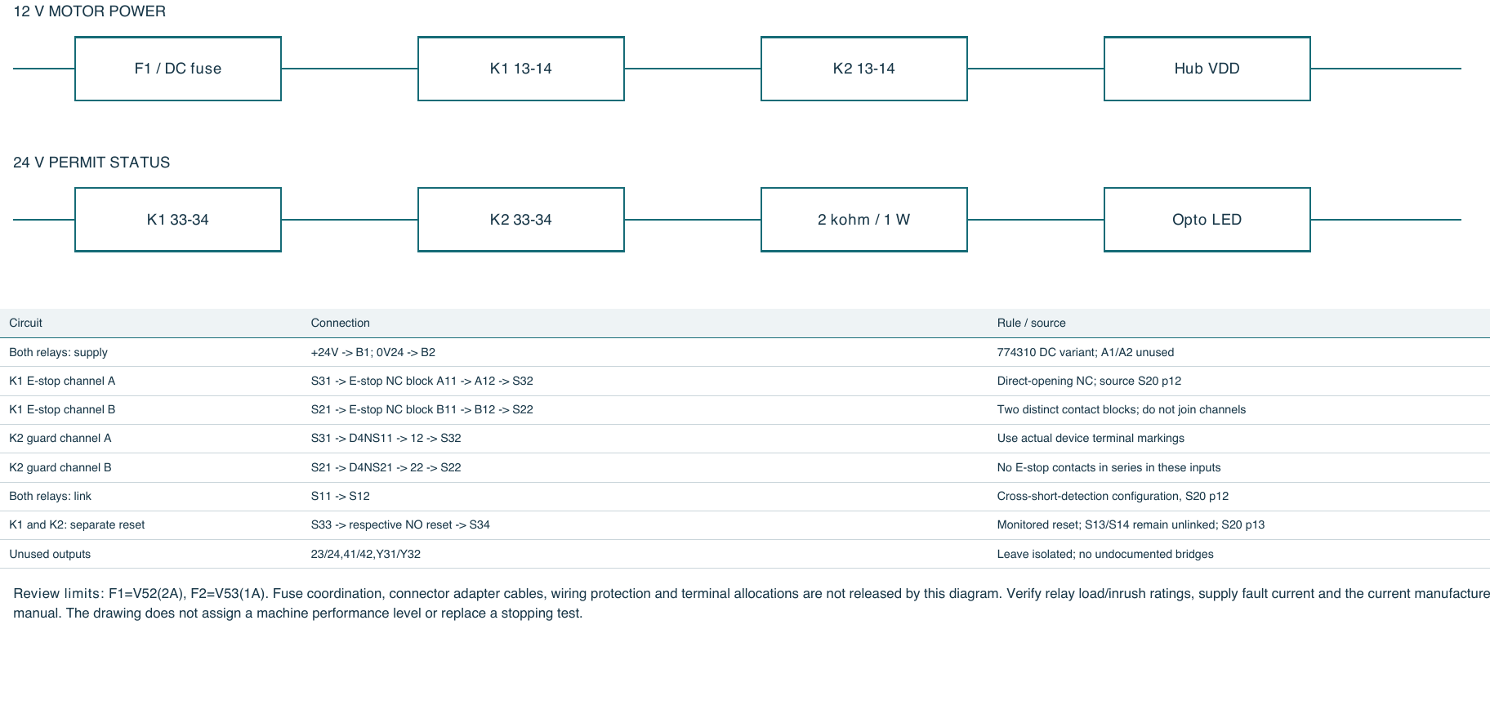
[picture p62: figure]

AT-018 | mm | CAD views NTS | dimensions govern | DEVELOPMENT REVIEW - NOT A FABRICATION RELEASE | 2026-11-05 | Sheet 19

### 1. Have the responsible electrical engineer approve E-001 against the exact

PNOZ X3 manual shipped with both relays. This is a wiring review operation, not authorization to bypass P4.

### 2. Use B1/B2 for each relay's 24V DC supply. The dual-channel

cross-short-detection diagram uses separate S21/S22 and S31/S32 channels with the S11/S12 link shown by the manufacturer.

### 3. Use a separate physical monitored-reset button across S33/S34 on each

relay. Leave automatic-start S13/S14 unlinked. Label each reset function.

4. Motor positive power passes through a safety output of K1 and then K2. Verify that either device can remove motor voltage independently. Pi power stays on for logging.

### 5. Keep 24V status isolated from Pi logic. Follow the existing active-high

permit interface; connecting a 24V relay terminal directly to a Pi pin will damage the Pi.

Inspection / stop point
Record point-to-point continuity, insulation where applicable, polarity, terminal torque, fuse identity and supply voltage. Full wiring/safety acceptance is still a physical P4 test.

SHOP RECORD
Actual measurement / observation: ______________________________________ _________________________________________________________________ Assembler __________ Inspector __________ Date __________ Pass / Hold

# 19 / Install the controller and qualify operation

Raspberry Pi | existing src/foldbench software | approved calibration file | dummy
AT-019 | mm | CAD views NTS | dimensions govern | DEVELOPMENT REVIEW - NOT A FABRICATION RELEASE | 2026-11-05 | Sheet 20

### 1. Install the existing Pipenv-managed application and service following the

repository deployment instructions. Keep simulation as the default until commissioning records are complete.

### 2. Identify the actual U2D2 serial path, GPIO chip, case probe and ambient

probe. Verify input polarity and both endpoint signals by hand with motor power isolated.

### 3. Index the mechanically uncoupled actuator, then establish

encoder-to-fixture correspondence. CAD fixture rotation increases toward closed; software phone angle increases toward open. Confirm direction physically.

### 4. Run slow dummy-only cycles. Operate emergency stop and guard

separately during both directions; measure motor voltage loss, stopping time, coast angle and any gravity settling.

### 5. Verify no restart on restored power, released E-stop, replaced guard, API

reconnection or Pi reboot. Only a deliberate physical reset plus a new authorized run may start motion.

Inspection / stop point
Record physical acceptance separately from simulator results. Reject operation if any missing sensor is bypassed, clutch slip is unmeasured, or a stop/reset test fails.

SHOP RECORD
Actual measurement / observation: ______________________________________ _________________________________________________________________ Assembler __________ Inspector __________ Date __________ Pass / Hold

# 20 / Release the station and preserve the as-built record

Completed P1-P4 records | final BOM/drawings | calibration and inspection log
AT-020 | mm | CAD views NTS | dimensions govern | DEVELOPMENT REVIEW - NOT A FABRICATION RELEASE | 2026-11-05 | Sheet 21

### 1. Replace every development hold with a signed disposition and the final

drawing/part number. Update the STEP model, hole charts and fastener list to match the assembled hardware.

2. Record torque checks, rail friction, clutch settings cold/warm, balance, clearance, stop times, endpoint states and temperature-probe mapping.

### 3. Perform a supervised dummy endurance trial and inspect for loose

fasteners, pad creep, guide wear, heating and changing clutch behavior. Establish maintenance intervals from measurements.

4. Only then install the measured phone under the approved test conditions. Start with short supervised runs and inspect the hinge, case contact marks and temperature.

### 5. Archive source URLs, vendor documents, software commit, calibration file

and photographs under the bench serial. Recommission after changing any drive, fixture, sensor or safety component.

Inspection / stop point
This traveler becomes an as-built assembly record only after the shop completes it. No physical assembly or testing has been performed by the document generator.

SHOP RECORD
Actual measurement / observation: ______________________________________ _________________________________________________________________ Assembler __________ Inspector __________ Date __________ Pass / Hold

# Actual-phone metrology / insert design input

Owner decision: shop measures the phone before machining inserts | no assumed Apple dimensions
PM-001 | mm | CAD views NTS | dimensions govern | DEVELOPMENT REVIEW - NOT A FABRICATION RELEASE | 2026-11-05 | Sheet 22

Device/model ____________________ Serial __________ Case fitted / bare __________ Inspector __________ Date __________
Instrument ID __________ Resolution __________ Calibration __________ Photos/datum sketch reference __________
Measurement / datum | Method and required record | Actual mm
Datum A / B / C | A=fixed-half supported back plane; B=long side edge; C=end face. Attach an annotated actual phone photograph showing the datums and axes. | __________
Half lengths L1 / L2 | Measure each half independently; record corner radii and taper at the contact locations. | ____ / ____
Half widths W1 / W2 | Measure from hinge-side boundary to outer edge; distinguish case/frame from active display. | ____ / ____
Contact thickness T1 / T2 | Measure at each planned clamp/support point; photograph the point labels. | ____ / ____
Camera and other protrusions | Record outline, XY position from B/C and height above A. Include cable plugs in the required swept envelope. | __________
Keep-out map | Outline display, hinge seam, buttons, ports, speakers and fragile finishes. No pad or retaining finger may land in a keep-out. | Drawing ____
Mass / moving-half load | Weigh whole phone; measure assembled moving torque using the approved dummy before selecting final counterweight settings. | ____ g
Permitted test angles | Obtain owner/device limits; never force a mechanical endpoint to discover range. | ____ to ____ deg

Insert release deliverables: dimensioned insert drawings with datum/fastener pattern, material and finish; pad thickness/adhesive; retention method; actual-device keep-out overlay; dummy drawing; and approved contact photographs. Record clearance and pad compression at every contact. The two current flat trays are mounting interfaces, not completed phone-retention fixtures.

# Hinge-motion and fit acceptance record

Measure without forcing the phone | fixture angle0=open; record any restricted range
PM-002 | mm | CAD views NTS | dimensions govern | DEVELOPMENT REVIEW - NOT A FABRICATION RELEASE | 2026-11-05 | Sheet 23

Place the fixed half on a protected reference support. Track at least two non-collinear fiducials on the moving half with a calibrated optical or coordinate method. Record moving-back-plane translation and rotation relative to datum A at each angle; do not infer a stationary hinge axis from the phone's exterior seam.

Fixture angle | Measured angle | Delta X mm | Delta Z mm | Remaining float mm | Contact / interference
0 deg | ________ | ________ | ________ | ________ | ________________________
30 deg | ________ | ________ | ________ | ________ | ________________________
60 deg | ________ | ________ | ________ | ________ | ________________________
90 deg | ________ | ________ | ________ | ________ | ________________________
120 deg | ________ | ________ | ________ | ________ | ________________________
150 deg | ________ | ________ | ________ | ________ | ________________________
180 deg | ________ | ________ | ________ | ________ | ________________________

Compliance decision: required measured travel ________mm; uncertainty ________mm; reserved margin ________mm. The present guide provides only one-axis translation, nominally +/-5.7..6.0mm. If measured out-of-plane motion or rotation cannot be accommodated by the released contacts, revise the fixture before testing the phone.

Dummy acceptance: no display/hinge-seam load; no retainer migration; retained at every permitted angle; no travel-stop contact in normal motion; no pad snag or cable tension. Record the worst contact clearance and force. Use a force gauge; servo current is not a contact-force reading.

P1 disposition: approved / revise / rejected
Final insert drawing IDs ____________________ Dummy drawing __________
Mechanical owner __________ Shop lead __________ Date __________
Attach the completed measurement file and actual-device photographs to the bench serial record.

# Verification and release boundary

Computer checks establish model consistency; physical acceptance remains separate

QA-001 | mm | CAD views NTS | dimensions govern | DEVELOPMENT REVIEW - NOT A FABRICATION RELEASE | 2026-11-05 | Sheet 24
Check | Result | What was checked
Custom solid validity | True | OpenCascade validity for every exported custom part
Moving sweep against base, tray, posts and towers | 0 overlaps | 37 positions, 0..180 degrees in 5-degree steps; >0.01 mm3 threshold
Lowest sampled moving surface | 6.67 mm above base | At nominal counterweight settings; excludes wiring and screw heads
Phone geometry / clutch insertion / safety validation | NOT VERIFIED | Actual phone, configured clutch drawing and assembled hardware required

P1 - Phone-contact inserts
Measure the actual iPhone Duo case, hinge-axis path, protrusions, buttons and screen keep-outs. Release contact inserts and retention features after an actual fit test. The current rectangular envelope is not verified.

P2 - Configured clutch and shaft interfaces
Obtain Dynatect's drawing for an EAS12 shaft-to-shaft clutch with two exact 6 mm bores. Confirm insertion depths, set-screw locations and stable 0.20 N m bidirectional slip. Confirm B122 center-bolt clearance and finish the shaft flats from the approved stack.

P3 - Guard sensing and endpoint sensing
Fit-check B128-B130 interlock/key mounts against the purchased devices. B125-B127 define endpoint mounts and cam. Confirm their switch actuation before hard-stop contact and guard opening before any reachable motion. Record actual switch-body bolt lengths, key sleeve lengths, insertion datum and both-channel opening behavior.

P4 - Electrical panel and machine acceptance
Finish the cabinet mounting/cutout layout, fuse coordination and wiring release for the exact purchased components. Perform the independent stop, reset, restart, cable-disconnect and thermal tests. This issue has no machine safety-category certification.

Release signature: mechanical owner __________ electrical owner __________ shop lead __________ date __________
Do not mark a hold closed merely because the associated STEP file opens or a simulated cycle passes.
