nkocode/test-equipment-iphone-duo-foldatron/revisions/rev-c/software/project/README.md

# foldatron Rev C runtime source

Self-contained source-layout copy of the maintained root package. Use Pipenv and `python -m foldbench.revc`. Simulation is the default. See ../README.md and ../protocols.md before installation. The original entry point remains for compatibility; it is not the Rev C driver. Regenerate this copy with package_review.py.
