nkocode/test-equipment-iphone-duo-foldatron/revisions/rev-c/docs/fastener-schedule.md

# Rev C fastener interface schedule

C-0.3 / 2026-11-13. Millimetres unless marked inch. Nominal projections are
seat-to-joint calculations, not final torque or thread-strength approval.
Use this schedule with the vendor drawings and actual received parts.

| Joint | Qty | Purchased screw / associated part | Seat stack | Projection | Verification |
|---|---:|---|---:|---:|---|
| 4151 frame and door plates | 80 | 80/20 3321 complete set | Vendor matched | Vendor matched | Five sets per plate; 16 plates |
| 4119 brackets | 24 | 80/20 3061 + 3382 | Vendor matched | Vendor matched | Two per bracket; positions still under review |
| Door hinges | 8 | 80/20 3386 complete assembly | Vendor matched | Vendor matched | Four per 2086 hinge |
| Door handle | 2 | 80/20 3491 | Vendor matched | Vendor matched | 2062 handle |
| Rotary rail to stage top | 2 | ISO 4762 M6 x 8 | 2.540 | 5.460 | M6 x 10 is too long; no substitution |
| Moving BA2/M to RC2/M | 2 | Bolt Depot 6395 M4 x 14 + SD1 | 8.509 | 5.491 | RC2 usable thread depth 6 nominal |
| Fixed AB90 to RC2/M | 2 | Bolt Depot 6396 M4 x 16 + SD1 | 10.287 | 5.713 | RC2 usable thread depth 6 nominal |
| Moving AB90 to XY top | 2 | Bolt Depot 15052 #6-32 x 5/8 + SD1 | 10.287 | 5.588 | SD1/#6 head bearing requires approval M02 |
| XY base to BA2 outer slot | 2 | Bolt Depot 15054 #6-32 x 7/8 + #6 nut/washer | Receiving check | Receiving check | Two through holes; do not tap either component |
| Holder to BA1/M | 4 | Bolt Depot 6417 M6 x 12 | 6.952 | 5.048 | Measure usable blind thread; never bottom screw |
| BA1 outer slots to mast | 8 | M6 x 18 + DIN 125 M6 washer + 3873 nut | 11.600 | 6.400 | Confirm stock order code and nut engagement |
| AB90 vertical slot to mast | 4 | M6 x 16 + 3873 nut | 8.255 | 7.745 | Only 0.459 nominal slot-floor margin; review tolerance |
| Breadboard to support slots | 4 | M6 x 12 + 3873 nut | 6.500 | 5.500 | Approximately 3.29 usable engagement after slot lip; review |
| Stage base to breadboard | 3 | M6 x 16 | 5.500 | 10.500 | Through-tapped 12.7 board; verify underside clearance |
| Fixed rail to breadboard | See rail drawing | M6 x 8 candidate | 2.540 | 5.460 | Final hole selection and thread strength review |
| BNS sensor and actuator | 4 | M4 x 20 + DIN 125 M4 washer + 3666 nut candidate | 13.8 | 6.2 | Verify molded seat, washer and slot engagement |

Do not order the unresolved rows as a complete kit. M02 is open until every
selected length has a catalog order code, quantity, positive seating,
adequate engagement and tool access. Select ordinary catalog washers or
lengths when adjusting a stack; grinding screws, drilling clearance holes,
slotting plates and modifying purchased bearings are prohibited.

For a T-slot joint, measure screw projection below the mating face and
compare it with both the nut's thread engagement and the slot floor. A
screw can feel tight because it has bottomed while the joint remains loose.
For a blind tapped joint, leave positive bottom clearance and verify that
unthreaded lead-in is excluded from usable engagement. Record these checks
in the assembly traveler before threadlocker or final tightening.

Original vendor CAD is available for the Thorlabs interfaces. The Del-Tron
body is a drawing reconstruction. Its #6-32 threads are not M4. SD1 is sold
for #8/M4; the proposed #6 application has nominal bearing area, but has not
been accepted as a vendor-matched connection. Do not conceal that distinction
with a generic hardware symbol in a drawing.
