nkocode/test-equipment-iphone-duo-foldatron/revisions/rev-c/visualization/index.html

foldatronREV C / ASSEMBLY STUDY

Development geometry

CATALOG COMPONENTS

# Rev C mechanical assembly.

Outside-surface vacuum grips. Inspect the 1010 guard, purchased motion fixture and control-enclosure layout.

## Phone opening

180°

ClosedOpen

Play motionWhole benchFixture detail

FrontSidePlanClosed detail

Front, side and plan use orthographic projection. Drag to inspect from any angle.

## Assembly layers

0%

Show guard Show controls Open guard door Show surrogate phone Show stationary grip Show moving grip

Inspect a component

### Purchased interfaces

The stage, rails, carriers and plates use original vendor solids. Other parts are identified as catalog interface models.

Surrogate: 70 × 160 × 5 mm per leaf. Assembly study: hose routing, some hardware and cabinet mounting remain unfinished. Phone geometry and physical acceptance require measurement. This is a motion study, not a machine-control screen.

01 / BENCH ASSEMBLY

Assembled · natural-closure concept

1010 profile · 762 × 762 × 660.4 mm frame

Preparing assembly…

Drag to orbit · Scroll to zoom · Select a part
