nkocode/test-equipment-iphone-duo-foldatron/revisions/rev-b/project/visualization/index.html

foldatronREV BCAD MOTION STUDYAssembly manual ↗ (https://github.com/nkocode/test-equipment-iphone-duo-foldatron/blob/main/docs/rev-b/Foldatron-Rev-B-assembly-traveler.pdf)Reset study ↺

1010 STRUCTURE / DRAWING-DERIVED GEOMETRY

# Folding mechanism

122 CAD instances · dimensions in millimetres

Ready1× playback

Loading Rev B CAD…

BenchMechanismEndpointsInterlockTop

Run study ▶

Phone opening 175.0°

5° closed175° open

CYCLES000000:00 simulated

OPENING
5–175°LAST
60 s

CYCLE RECIPE VIRTUAL ONLY

Travel speed

°/s

Endpoint dwell

s

Playback

PermitOpenClosed

SIMULATED INPUTS

Front guard removedEmergency stop pressed

Reset simulated permit

A full cycle closes, dwells, opens and dwells.

Radial carriage offset 0.0 mm

Manual fit study. Actual phone hinge motion is unmeasured.

ASSEMBLIES 122 INSTANCES

Find a part or instance

Focus partIsolate assembly

ASSEMBLY TRAVELER 01 / 20

Assembly operation

INSPECTION / HOLD

← PreviousNext →

Open traveler ↗

DISPLAY

Clear panelsReference specimenAxis & dimensions

Separate assemblies 0%

Presentation view; motion runs only when assembled.

SELECTED COMPONENT SYSTEM

## Rev B geometry

Machined parts come directly from the drawing CAD. Purchased parts retain their documented interface envelopes.

Frame

660.4 × 558.8 × 558.8 mm

Hinge axis

140 mm above base

Base

500 × 460 × 8 mm

Drawing book ↗ (https://github.com/nkocode/test-equipment-iphone-duo-foldatron/blob/main/docs/rev-b/Foldatron-Rev-B-drawing-book.pdf)

Model limits & release holds

This is a kinematic study, not a stress or safety simulation. No machine connection.

- P1 · Shop-measured phone inserts
- P2 · Configured clutch interfaces
- P3 · Physical sensor/guard acceptance
- P4 · Electrical completion and acceptance

Stop inputs halt virtual motion immediately; coast, gravity settling, force and stopping time are not predicted. Motion uses an assumed 60°/s² ramp. Endpoint LEDs use nominal thresholds (≤5.5° closed, ≥174.5° open), not a validated cam/contact model.

CAD clearance evidence: 6.665 mm minimum moving Z at 5° samples. Excludes phone, wiring, screw heads and switch deflection; offset carriage motion is not collision-checked. Individual fasteners, harnesses and cabinet internals are not fully modeled.

OFFLINE SIMULATION · NO MACHINE CONNECTIONRev B drawings, BOM & evidence ↗ (https://github.com/nkocode/test-equipment-iphone-duo-foldatron/tree/main/hardware/rev-b)
