nkocode/test-equipment-iphone-duo-foldatron/revisions/rev-a/project/visualization/index.html

foldatron01ENGINEERING EXPLORER 01 / REV AAssembly manual ↗ (https://github.com/nkocode/test-equipment-iphone-duo-foldatron/blob/main/docs/Foldatron-illustrated-assembly-manual.pdf)

FOLDING ENDURANCE BENCH

# Inside the machine.

Interactive assembly · design study

Preparing the bench…

PerspectiveMechanismTop↺ Reset

Complete benchDRAG TO ORBIT · SCROLL TO ZOOM

▶

Hinge opening 110°

5° closed limit175° open limit

ILLUSTRATIVE MOTION
Paused · manual angle

01 — ASSEMBLIES SELECT TO INSPECT

Separate assemblies 0%

AssembledExploded

Show protective enclosure

ASSEMBLY WALKTHROUGH 01 / 08

← PreviousNext →

Open detailed instructions ↗

COMPONENT NOTES SYSTEM

## Designed to repeat.

A Raspberry Pi coordinates a torque-limited folding fixture. Explore the assemblies to follow the mechanical and control paths.

Base plate

500 × 400 mm

Nominal hinge height

140 mm

Station parts allowance

$2,510 USD

REV A · CONCEPT GEOMETRY

A moving diagram of the proposed design. Phone fit, clearances and force limits require physical validation.

DESIGN STUDY / No live machine connectionSource & bill of materials ↗ (https://github.com/nkocode/test-equipment-iphone-duo-foldatron)NOMINAL DIMENSIONS · NO PHYSICS ENGINE
