nkocode/test-equipment-iphone-duo-foldatron/revisions/rev-a/README.md

# foldatron REV-A — preserved snapshot

Concept design and original interactive explorer. Source commit: `516acfce436bfdb4f58c6955ddaff594326ae535`.

Every tracked file from that commit is preserved byte-for-byte under `project/`, including controller source, dependencies, drawings, BOM, build scripts, tests and visualization. This snapshot is immutable; corrections belong in a later revision or a separate errata note.

- [Open/download the original viewer](project/visualization/index.html)
- [Drawings / illustrated manual](project/docs/Foldatron-illustrated-assembly-manual.pdf)
- [Full project index](project/README.md)
- [Source-file SHA-256 manifest](manifest.json)

Untracked virtual environments, downloaded vendor documents and local caches were never part of the Git source snapshot. Rev B source-register URLs and hashes identify the vendor references; the separately delivered engineering package also contains the acquired vendor files.

Historical software and engineering holds remain as written. Archiving does not qualify the hardware or update dependencies.
