nkocode/test-equipment-iphone-duo-foldatron/(commit log)

2026-11-05 Add FoldBench tester design and src-layout Python controller
    [foldbench.scad]
2026-11-05 Add illustrated step-by-step bench assembly manual
2026-11-06 Add vendor-backed Rev B 1010 CAD and engineering review package
    [B101.dxf, B101.step, B102.step, B103.dxf, B103.step, B104.step, B105.dxf, B105.step]
2026-11-06 Replace concept viewer with Rev B CAD motion study and assembly walkthrough
2026-11-06 Preserve complete Rev A and Rev B snapshots and publish revision gallery
    [B101.dxf, B101.step, B102.step, B103.dxf, B103.step, B104.step, B105.dxf, B105.step]
2026-11-07 Add Rev C catalog interface review and full-closure requirements
    [procurement-status.csv, structure-study.step, top-interface-study.step]
2026-11-13 Publish Rev C catalog mechanical assembly and review viewer
    [assembly-parts.tsv, bench-development.step, fixture-development.step, structure-study.step, top-interface-study.step]
2026-11-13 Pin gallery to the Rev C mechanical review snapshot
